Pipo927/Micro-Hidroponic-web/Manual.html

# EC

 get_row( "SELECT * FROM `OUTPUT` WHERE id=1", ARRAY_N); if(isset($_POST['change1'])) { if($ready1==NULL) { echo "Insira uma planta"; } else { $EC= $_POST["EC"]; if($ready1[4]>$EC) { echo " Insira um valor entre $ready1[4] e 3"; } else { $wpdb->update('OUTPUT', array('EC' =>$EC), array('id'=>1), array('%s')); } } } ?>

# pH

 get_row("SELECT * FROM `INPUT`ORDER BY id DESC LIMIT 1", ARRAY_N);if ($myresult){echo "$myresult[2]";}else {echo "Insira uma planta";}?>

# Lâmpada

get_row( "SELECT * FROM `OUTPUT` WHERE id=1", ARRAY_N); if($ready3[2]==1){echo "Ligar";}else {echo "Desligar";}?> get_row( "SELECT * FROM `OUTPUT` WHERE id=1", ARRAY_N); if(isset($_POST['change3'])) { if($ready4[2]==1) { $wpdb->update('OUTPUT', array('LAMPADA' =>"0"), array('id'=>1), array('%s')); $wpdb->update('OUTPUT', array('MODO_AUTOMATICO' =>"0"), array('id'=>1), array('%s')); } else { $wpdb->update('OUTPUT', array('LAMPADA' =>"1"), array('id'=>1), array('%s')); $wpdb->update('OUTPUT', array('MODO_AUTOMATICO' =>"0"), array('id'=>1), array('%s')); } } ?> get_row( "SELECT * FROM `OUTPUT` WHERE id=1", ARRAY_N); if($automatic[7]==1){echo "disabled" ;} else{echo 'style=" background-color: #4CB62C; border: none; color: white; padding: 15px 32px; text-align: center; text-decoration: none; display: inline-block; font-size: 16px; margin: 4px 2px; cursor: pointer;"';}?>> Modo Automático get_row( "SELECT * FROM `OUTPUT` WHERE id=1", ARRAY_N); if(isset($_POST['automatic'])) { echo ""; $wpdb->update('OUTPUT', array('MODO_AUTOMATICO' =>"1"), array('id'=>1), array('%s')); } ?>
